edwardatki/e74-cpu/(list of files, drawings)

Other design files:
cpu.circ
