edwardatki/e74-cpu/hardware/Control_board/Control_board.kicad_pcb

## KiCad design hardware/Control_board/Control_board.kicad_pcb (2023-09-10)

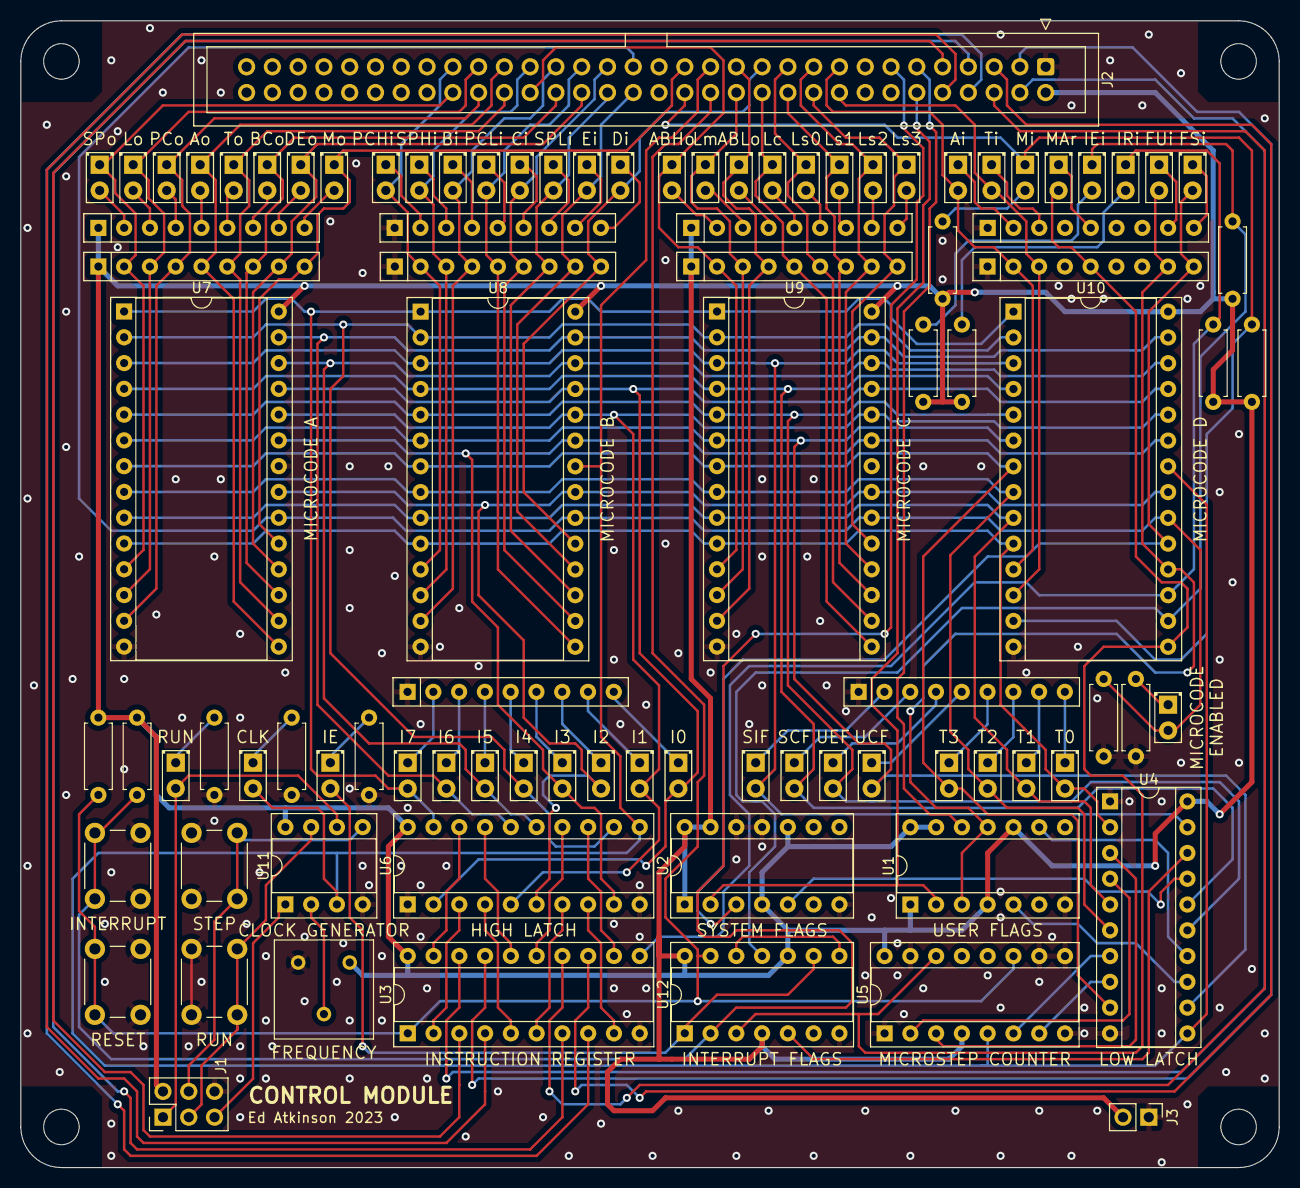
[picture p1: board Control_board.kicad_pcb from above]

Board: 2 copper layers, 124.0 x 113.0 mm, 99 parts (0 on the bottom side), 139 nets.

Parts:
D1, D2, D3, D4, D5, D6, D7, D8, D9, D10, D11, D12, D13, D14, D15, D16, D17, D18, D19, D20, D21, D22, D23, D24, D25, D26, D27, D28, D29, D30, D31, D32, D33, D34, D35, D36, D37, D38, D39, D40, D41, D42, D43, D44, D45, D46, D47, D48, D49, D50, D51, D52: LED; LED_D2.0mm_W4.8mm_H2.5mm_FlatTop
H1, H2, H3, H4: MountingHole; MountingHole_3.5mm
J1: ICSP; PinHeader_2x03_P2.54mm_Vertical
J2: Conn_02x32_Odd_Even; IDC-Header_2x32_P2.54mm_Vertical
J3: Conn_01x02; PinHeader_1x02_P2.54mm_Vertical
R1, R5, R6, R10, R11, R13: 1K; R_Axial_DIN0207_L6.3mm_D2.5mm_P7.62mm_Horizontal
R2, R3, R4, R7, R8, R9, R12: 330R; R_Axial_DIN0207_L6.3mm_D2.5mm_P7.62mm_Horizontal
RN1, RN2, RN3, RN4: 1K; R_Array_SIP9
RN5, RN6, RN7, RN8, RN9, RN10: 330R; R_Array_SIP9
RV1: R_Potentiometer; Potentiometer_Bourns_3386F_Vertical
SW1, SW2, SW3, SW4: SW_Push; SW_PUSH_6mm
U1, U2, U12: 74LS74; DIP-14_W7.62mm_Socket
U3: 74LS273; DIP-20_W7.62mm_Socket
U4, U6: 74LS373; DIP-20_W7.62mm_Socket
U5: 74LS192; DIP-16_W7.62mm_Socket
U7, U8, U9, U10: 27C512; DIP-28_W15.24mm_Socket
U11: ATtiny85-20P; DIP-8_W7.62mm_Socket

Connections:
+5V: J1.2, J2.2, J3.2, R1.1, R5.1, R6.1, R7.2, R8.2, R9.2, R10.1, R13.1, RN3.1 (common), RN4.1 (common), RN8.1 (common), RN10.1 (common), RV1.3, U1.1 (~R), U1.4 (~S), U1.10 (~S), U1.13 (~R), U1.14 (VCC), U2.1 (~R), U2.4 (~S), U2.10 (~S), U2.13 (~R), U2.14 (VCC), U3.20 (VCC), U4.20 (VCC), U5.4 (DOWN), U5.16 (VCC), U6.20 (VCC), U7.28 (VCC), U8.28 (VCC), U9.28 (VCC), U10.28 (VCC), U11.8 (VCC), U12.4 (~S), U12.10 (~S), U12.14 (VCC)
/ALU_M: D45.1 (K), J2.26, RN4.3 (R2), U9.12 (D1)
/ALU_S0: D48.1 (K), J2.21, RN4.6 (R5), U9.16 (D4)
/ALU_S1: D49.1 (K), J2.22, RN4.7 (R6), U9.17 (D5)
/ALU_S2: D50.1 (K), J2.19, RN4.8 (R7), U9.18 (D6)
/ALU_S3: D51.1 (K), J2.20, RN4.9 (R8), U9.19 (D7)
/A_LOAD: D23.2 (A), J2.17, RN1.2 (R1), U10.11 (D0)
/B_LOAD: D38.2 (A), J2.39, RN2.4 (R3), U8.13 (D2)
/CARRY_FLAG: J2.12, U1.2 (D), U2.2 (D)
/CLK: D2.2 (A), J2.27, U4.11 (LE), U5.5 (UP), U6.11 (LE), U8.22 (~OE), U10.22 (~OE), U11.3 (XTAL2/PB4)
/CONTROL_DISABLE: D52.2 (A), J2.33, R11.1, U7.20 (~CE), U8.20 (~CE), U9.20 (~CE), U10.20 (~CE)
/COUNTER_RESET: D25.2 (A), RN1.5 (R4), U5.14 (CLR), U10.15 (D3), U12.3 (C)
/C_LOAD: D40.2 (A), J2.35, RN2.6 (R5), U8.16 (D4)
/D0: J2.9, U3.3 (D0)
/D1: J2.10, U3.4 (D1)
/D2: J2.7, U3.7 (D2)
/D3: J2.8, U3.8 (D3)
/D4: J2.5, U3.13 (D4)
/D5: J2.6, U3.14 (D5)
/D6: J2.3, U3.17 (D6)
/D7: J2.4, U3.18 (D7)
/D_LOAD: D43.2 (A), J2.23, RN2.9 (R8), U8.19 (D7)
/EQUAL_FLAG: J2.11, U1.12 (D)
/E_LOAD: D42.2 (A), J2.34, RN2.8 (R7), U8.18 (D6)
/FLAGS_A_UPDATE: D26.2 (A), RN1.8 (R7), U1.3 (C), U1.11 (C), U10.18 (D6)
/FLAGS_B_UPDATE: D27.2 (A), RN1.9 (R8), U2.3 (C), U10.19 (D7)
/INT_EN_TOGGLE: D21.1 (K), R5.2, U10.16 (D4), U12.11 (C)
/IR_LOAD: D20.1 (K), R1.2, U3.11 (Cp), U10.17 (D5)
/MA0: D3.2 (A), U4.2 (O0), U7.10 (A0), U8.10 (A0), U9.10 (A0), U10.10 (A0)
/MA1: D4.2 (A), U4.5 (O1), U7.9 (A1), U8.9 (A1), U9.9 (A1), U10.9 (A1)
/MA2: D5.2 (A), U4.6 (O2), U7.8 (A2), U8.8 (A2), U9.8 (A2), U10.8 (A2)
/MA3: D7.2 (A), U4.9 (O3), U7.7 (A3), U8.7 (A3), U9.7 (A3), U10.7 (A3)
/MA4: D8.2 (A), U4.12 (O4), U7.6 (A4), U8.6 (A4), U9.6 (A4), U10.6 (A4)
/MA5: D9.2 (A), U4.15 (O5), U7.5 (A5), U8.5 (A5), U9.5 (A5), U10.5 (A5)
/MA6: D10.2 (A), U4.16 (O6), U7.4 (A6), U8.4 (A6), U9.4 (A6), U10.4 (A6)
/MA7: D11.2 (A), U4.19 (O7), U7.3 (A7), U8.3 (A7), U9.3 (A7), U10.3 (A7)
/MA8: D12.2 (A), U6.2 (O0), U7.25 (A8), U8.25 (A8), U9.25 (A8), U10.25 (A8)
/MA9: D13.2 (A), U6.5 (O1), U7.24 (A9), U8.24 (A9), U9.24 (A9), U10.24 (A9)
/MA10: D14.2 (A), U6.6 (O2), U7.21 (A10), U8.21 (A10), U9.21 (A10), U10.21 (A10)
/MA11: D15.2 (A), U6.9 (O3), U7.23 (A11), U8.23 (A11), U9.23 (A11), U10.23 (A11)
/MA12: D16.2 (A), U6.12 (O4), U7.2 (A12), U8.2 (A12), U9.2 (A12), U10.2 (A12)
/MA13: D17.2 (A), U6.15 (O5), U7.26 (A13), U8.26 (A13), U9.26 (A13), U10.26 (A13)
/MA14: D18.2 (A), U6.16 (O6), U7.27 (A14), U8.27 (A14), U9.27 (A14), U10.27 (A14)
/MA15: D19.2 (A), U6.19 (O7), U7.1 (A15), U8.1 (A15), U9.1 (A15), U10.1 (A15)
/PC_H_LOAD: D36.2 (A), J2.47, RN2.2 (R1), U8.11 (D0)
/PC_L_LOAD: D39.2 (A), J2.37, RN2.5 (R4), U8.15 (D3)
/SP_H_LOAD: D37.2 (A), J2.41, RN2.3 (R2), U8.12 (D1)
/SP_L_LOAD: D41.2 (A), J2.36, RN2.7 (R6), U8.17 (D5)
/T_LOAD: D24.2 (A), J2.18, RN1.3 (R2), U10.12 (D1)
/~ADR_H_OUT: D44.1 (K), J2.42, RN4.2 (R1), U9.11 (D0)
/~ADR_L_OUT: D46.1 (K), J2.25, RN4.4 (R3), U9.13 (D2)
/~ALU_CIN: D47.1 (K), J2.24, RN4.5 (R4), U9.15 (D3)
/~ALU_OUT: D29.1 (K), J2.45, RN3.3 (R2), U7.12 (D1)
/~A_OUT: D31.1 (K), J2.43, RN3.5 (R4), U7.15 (D3)
/~BC_OUT: D33.1 (K), J2.40, RN3.7 (R6), U7.17 (D5)
/~DE_OUT: D34.1 (K), J2.38, RN3.8 (R7), U7.18 (D6)
/~INTERRUPT_FLAG: J2.13, R13.2, SW4.1, U12.2 (D)
/~PC_OUT: D30.1 (K), J2.46, RN3.4 (R3), U7.13 (D2)
/~RAM_LOAD: D22.1 (K), J2.30, R6.2, U10.13 (D2)
/~RAM_OUT: D35.1 (K), J2.29, RN3.9 (R8), U7.19 (D7)
/~RESET: J2.28, R10.2, SW3.1, U3.1 (~Mr), U5.11 (~LOAD), U12.13 (~R)
/~SP_OUT: D28.1 (K), J2.48, RN3.2 (R1), U7.11 (D0)
/~T_OUT: D32.1 (K), J2.44, RN3.6 (R5), U7.16 (D4)
GND: J1.6, J2.1, J3.1, R2.2, R3.2, R4.2, R11.2, R12.2, RN1.1 (common), RN2.1 (common), RN5.1 (common), RN6.1 (common), RN7.1 (common), RN9.1 (common), RV1.1, SW1.2, SW2.2, SW3.2, SW4.2, U1.7 (GND), U2.7 (GND), U2.11 (C), U2.12 (D), U3.10 (GND), U4.1 (OE), U4.10 (GND), U5.1 (B), U5.8 (GND), U5.9 (D), U5.10 (C), U5.15 (A), U6.1 (OE), U6.10 (GND), U7.14 (GND), U7.22 (~OE), U8.14 (GND), U9.14 (GND), U9.22 (~OE), U10.14 (GND), U11.4 (GND), U12.7 (GND)
unnamed: D1.2 (A), J1.1, U11.6 (PB1)
unnamed: D1.1 (K), R2.1
unnamed: D2.1 (K), R3.1
unnamed: D3.1 (K), RN5.9 (R8)
unnamed: D4.1 (K), RN5.8 (R7)
unnamed: D5.1 (K), RN5.7 (R6)
unnamed: D6.2 (A), U12.1 (~R), U12.9 (Q)
unnamed: D6.1 (K), R4.1
unnamed: D7.1 (K), RN5.6 (R5)
unnamed: D8.1 (K), RN5.5 (R4)
unnamed: D9.1 (K), RN5.4 (R3)
unnamed: D10.1 (K), RN5.3 (R2)
unnamed: D11.1 (K), RN5.2 (R1)
unnamed: D12.1 (K), RN6.9 (R8)
unnamed: D13.1 (K), RN6.8 (R7)
unnamed: D14.1 (K), RN6.7 (R6)
unnamed: D15.1 (K), RN6.6 (R5)
unnamed: D16.1 (K), RN6.5 (R4)
unnamed: D17.1 (K), RN6.4 (R3)
unnamed: D18.1 (K), RN6.3 (R2)
unnamed: D19.1 (K), RN6.2 (R1)
unnamed: D20.2 (A), R7.1
unnamed: D21.2 (A), R8.1
unnamed: D22.2 (A), R9.1
unnamed: D23.1 (K), RN7.2 (R1)
unnamed: D24.1 (K), RN7.3 (R2)
unnamed: D25.1 (K), RN7.5 (R4)
unnamed: D26.1 (K), RN7.8 (R7)
unnamed: D27.1 (K), RN7.9 (R8)
unnamed: D28.2 (A), RN8.2 (R1)
unnamed: D29.2 (A), RN8.3 (R2)
unnamed: D30.2 (A), RN8.4 (R3)
unnamed: D31.2 (A), RN8.5 (R4)
unnamed: D32.2 (A), RN8.6 (R5)
unnamed: D33.2 (A), RN8.7 (R6)
unnamed: D34.2 (A), RN8.8 (R7)
unnamed: D35.2 (A), RN8.9 (R8)
unnamed: D36.1 (K), RN9.2 (R1)
unnamed: D37.1 (K), RN9.3 (R2)
unnamed: D38.1 (K), RN9.4 (R3)
unnamed: D39.1 (K), RN9.5 (R4)
unnamed: D40.1 (K), RN9.6 (R5)
unnamed: D41.1 (K), RN9.7 (R6)
unnamed: D42.1 (K), RN9.8 (R7)
unnamed: D43.1 (K), RN9.9 (R8)
unnamed: D44.2 (A), RN10.2 (R1)
unnamed: D45.2 (A), RN10.3 (R2)
unnamed: D46.2 (A), RN10.4 (R3)
unnamed: D47.2 (A), RN10.5 (R4)
unnamed: D48.2 (A), RN10.6 (R5)
unnamed: D49.2 (A), RN10.7 (R6)
unnamed: D50.2 (A), RN10.8 (R7)
unnamed: D51.2 (A), RN10.9 (R8)
unnamed: D52.1 (K), R12.1
unnamed: J1.3, SW1.1, U11.7 (PB2)
unnamed: J1.4, SW2.1, U11.5 (AREF/PB0)
unnamed: J1.5, U11.1 (~RESET/PB5)
unnamed: U1.5 (Q), U4.13 (D4)
unnamed: U1.9 (Q), U4.14 (D5)
unnamed: U2.5 (Q), U4.17 (D6)
unnamed: U3.2 (Q0), U6.3 (D0)
unnamed: U3.5 (Q1), U6.4 (D1)
unnamed: U3.6 (Q2), U6.7 (D2)
unnamed: U3.9 (Q3), U6.8 (D3)
unnamed: U3.12 (Q4), U6.13 (D4)
unnamed: U3.15 (Q5), U6.14 (D5)
unnamed: U3.16 (Q6), U6.17 (D6)
unnamed: U3.19 (Q7), U6.18 (D7)
unnamed: U4.3 (D0), U5.3 (QA)
unnamed: U4.4 (D1), U5.2 (QB)
unnamed: U4.7 (D2), U5.6 (QC)
unnamed: U4.8 (D3), U5.7 (QD)
unnamed: RV1.2, U11.2 (XTAL1/PB3)
unnamed: U4.18 (D7), U12.5 (Q)
unnamed: U12.8 (~Q), U12.12 (D)
