edwardatki/e74-cpu/hardware/Memory_board/Memory_board.kicad_pcb

## KiCad design hardware/Memory_board/Memory_board.kicad_pcb (2023-09-10)

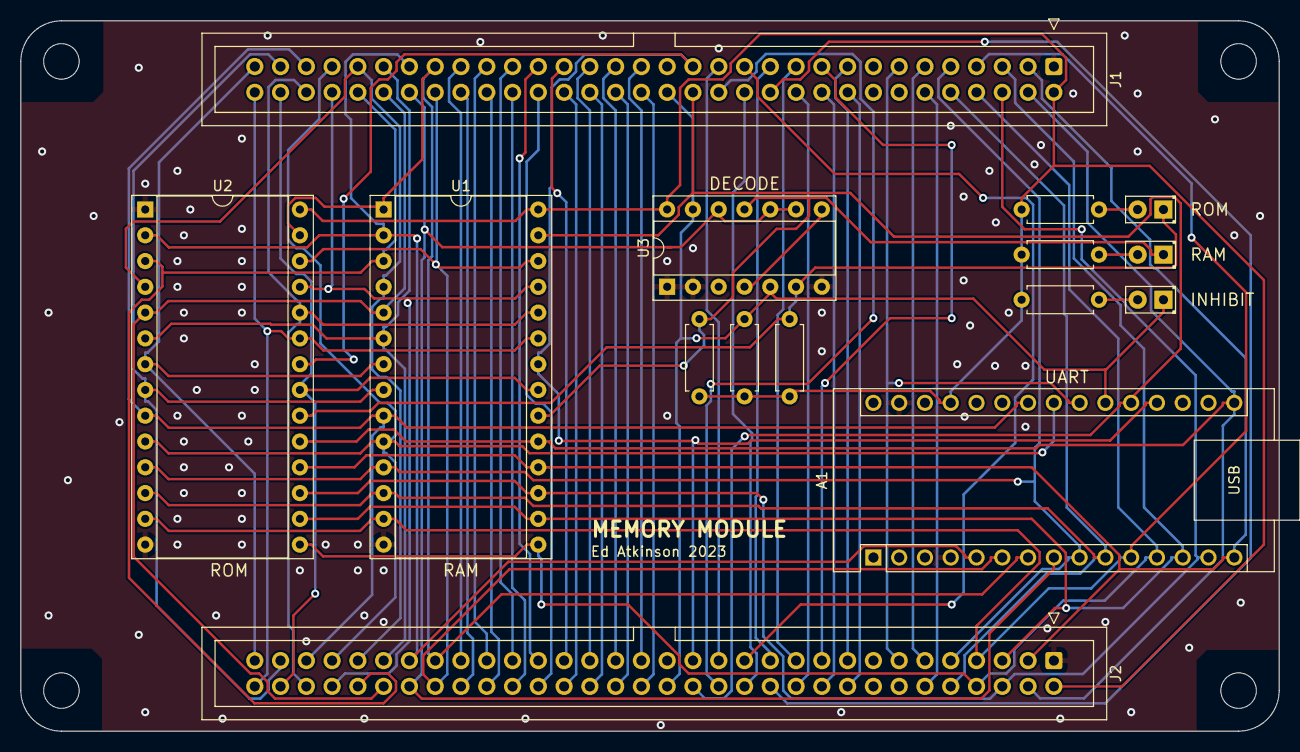
[picture p2: board Memory_board.kicad_pcb from above]

Board: 2 copper layers, 124.0 x 70.0 mm, 19 parts (0 on the bottom side), 66 nets.

Parts:
A1: Arduino_Nano_v3.x; Arduino_Nano
D1, D2, D3: LED; LED_D2.0mm_W4.8mm_H2.5mm_FlatTop
H1, H2, H3, H4: MountingHole; MountingHole_3.5mm
J1, J2: Conn_02x32_Odd_Even; IDC-Header_2x32_P2.54mm_Vertical
R1, R5, R6: 1K; R_Axial_DIN0207_L6.3mm_D2.5mm_P7.62mm_Horizontal
R2, R3, R4: 330R; R_Axial_DIN0207_L6.3mm_D2.5mm_P7.62mm_Horizontal
U1: CY62256-70PC; DIP-28_W15.24mm_Socket
U2: 27C512; DIP-28_W15.24mm_Socket
U3: 74LS00; DIP-14_W7.62mm_Socket

Connections:
+5V: A1.27 (+5V), J1.2, J2.2, R1.2, R2.2, R3.2, R4.2, R5.1, R6.1, U1.28 (VCC), U2.28 (VCC), U3.14 (VCC)
/A0: A1.23 (A4), J1.57, J2.57, U1.10 (A0), U2.10 (A0)
/A1: A1.24 (A5), J1.59, J2.59, U1.9 (A1), U2.9 (A1)
/A2: J1.61, J2.61, U1.8 (A2), U2.8 (A2)
/A3: J1.63, J2.63, U1.7 (A3), U2.7 (A3)
/A4: J1.53, J2.53, U1.6 (A4), U2.6 (A4)
/A5: J1.54, J2.54, U1.5 (A5), U2.5 (A5)
/A6: J1.55, J2.55, U1.4 (A6), U2.4 (A6)
/A7: J1.56, J2.56, U1.3 (A7), U2.3 (A7)
/A8: J1.58, J2.58, U1.25 (A8), U2.25 (A8)
/A9: J1.60, J2.60, U1.24 (A9), U2.24 (A9)
/A10: J1.62, J2.62, U1.21 (A10), U2.21 (A10)
/A11: J1.64, J2.64, U1.23 (A11), U2.23 (A11)
/A12: A1.5 (D2), J1.51, J2.51, U1.2 (A12), U2.2 (A12)
/A13: A1.6 (D3), J1.50, J2.50, U1.26 (A13), U2.26 (A13)
/A14: A1.7 (D4), J1.49, J2.49, U1.1 (A14), U2.27 (A14)
/A15: A1.8 (D5), J1.52, J2.52, U3.9, U3.10, U3.12
/ALU_M: J1.26, J2.26
/ALU_S0: J1.21, J2.21
/ALU_S1: J1.22, J2.22
/ALU_S2: J1.19, J2.19
/ALU_S3: J1.20, J2.20
/A_LOAD: J1.17, J2.17
/B_LOAD: J1.39, J2.39
/CARRY_FLAG: J1.12, J2.12
/CLK: J1.27, J2.27
/CONTROL_DISABLE: J1.33, J2.33
/C_LOAD: J1.35, J2.35
/D0: A1.9 (D6), J1.9, J2.9, U1.11 (Q0), U2.11 (D0)
/D1: A1.10 (D7), J1.10, J2.10, U1.12 (Q1), U2.12 (D1)
/D2: A1.11 (D8), J1.7, J2.7, U1.13 (Q2), U2.13 (D2)
/D3: A1.12 (D9), J1.8, J2.8, U1.15 (Q3), U2.15 (D3)
/D4: A1.13 (D10), J1.5, J2.5, U1.16 (Q4), U2.16 (D4)
/D5: A1.14 (D11), J1.6, J2.6, U1.17 (Q5), U2.17 (D5)
/D6: A1.15 (D12), J1.3, J2.3, U1.18 (Q6), U2.18 (D6)
/D7: A1.16 (D13), J1.4, J2.4, U1.19 (Q7), U2.19 (D7)
/D_LOAD: J1.23, J2.23
/EQUAL_FLAG: J1.11, J2.11
/E_LOAD: J1.34, J2.34
/PC_H_LOAD: J1.47, J2.47
/PC_L_LOAD: J1.37, J2.37
/SP_H_LOAD: J1.41, J2.41
/SP_L_LOAD: J1.36, J2.36
/T_LOAD: J1.18, J2.18
/~ADR_H_OUT: J1.42, J2.42
/~ADR_L_OUT: J1.25, J2.25
/~ALU_CIN: J1.24, J2.24
/~ALU_OUT: J1.45, J2.45
/~A_OUT: J1.43, J2.43
/~BC_OUT: J1.40, J2.40
/~DE_OUT: J1.38, J2.38
/~INTERRUPT_FLAG: A1.22 (A3), J1.13, J2.13
/~MEM_INHIBIT: A1.21 (A2), D3.1 (K), J1.32, J2.32, R1.1, U3.5, U3.13
/~MEM_LOAD: A1.20 (A1), J1.30, J2.30, U1.27 (~WE)
/~MEM_OUT: A1.19 (A0), J1.29, J2.29, U1.22 (~OE), U2.22 (~OE)
/~PC_OUT: J1.46, J2.46
/~RAM_CE: D1.1 (K), R5.2, U1.20 (~CS), U3.11
/~RESET: J1.28, J2.28
/~ROM_CE: D2.1 (K), R6.2, U2.20 (~CE), U3.6
/~SP_OUT: J1.48, J2.48
/~T_OUT: J1.44, J2.44
GND: A1.4 (GND), A1.29 (GND), J1.1, J2.1, U1.14 (GND), U2.1 (A15), U2.14 (GND), U3.1, U3.2, U3.7 (GND)
unnamed: D1.2 (A), R2.1
unnamed: D2.2 (A), R3.1
unnamed: D3.2 (A), R4.1
unnamed: U3.4, U3.8
