edwardatki/e74-cpu/hardware/Register_board/Register_board.kicad_pcb

## KiCad design hardware/Register_board/Register_board.kicad_pcb (2023-09-02)

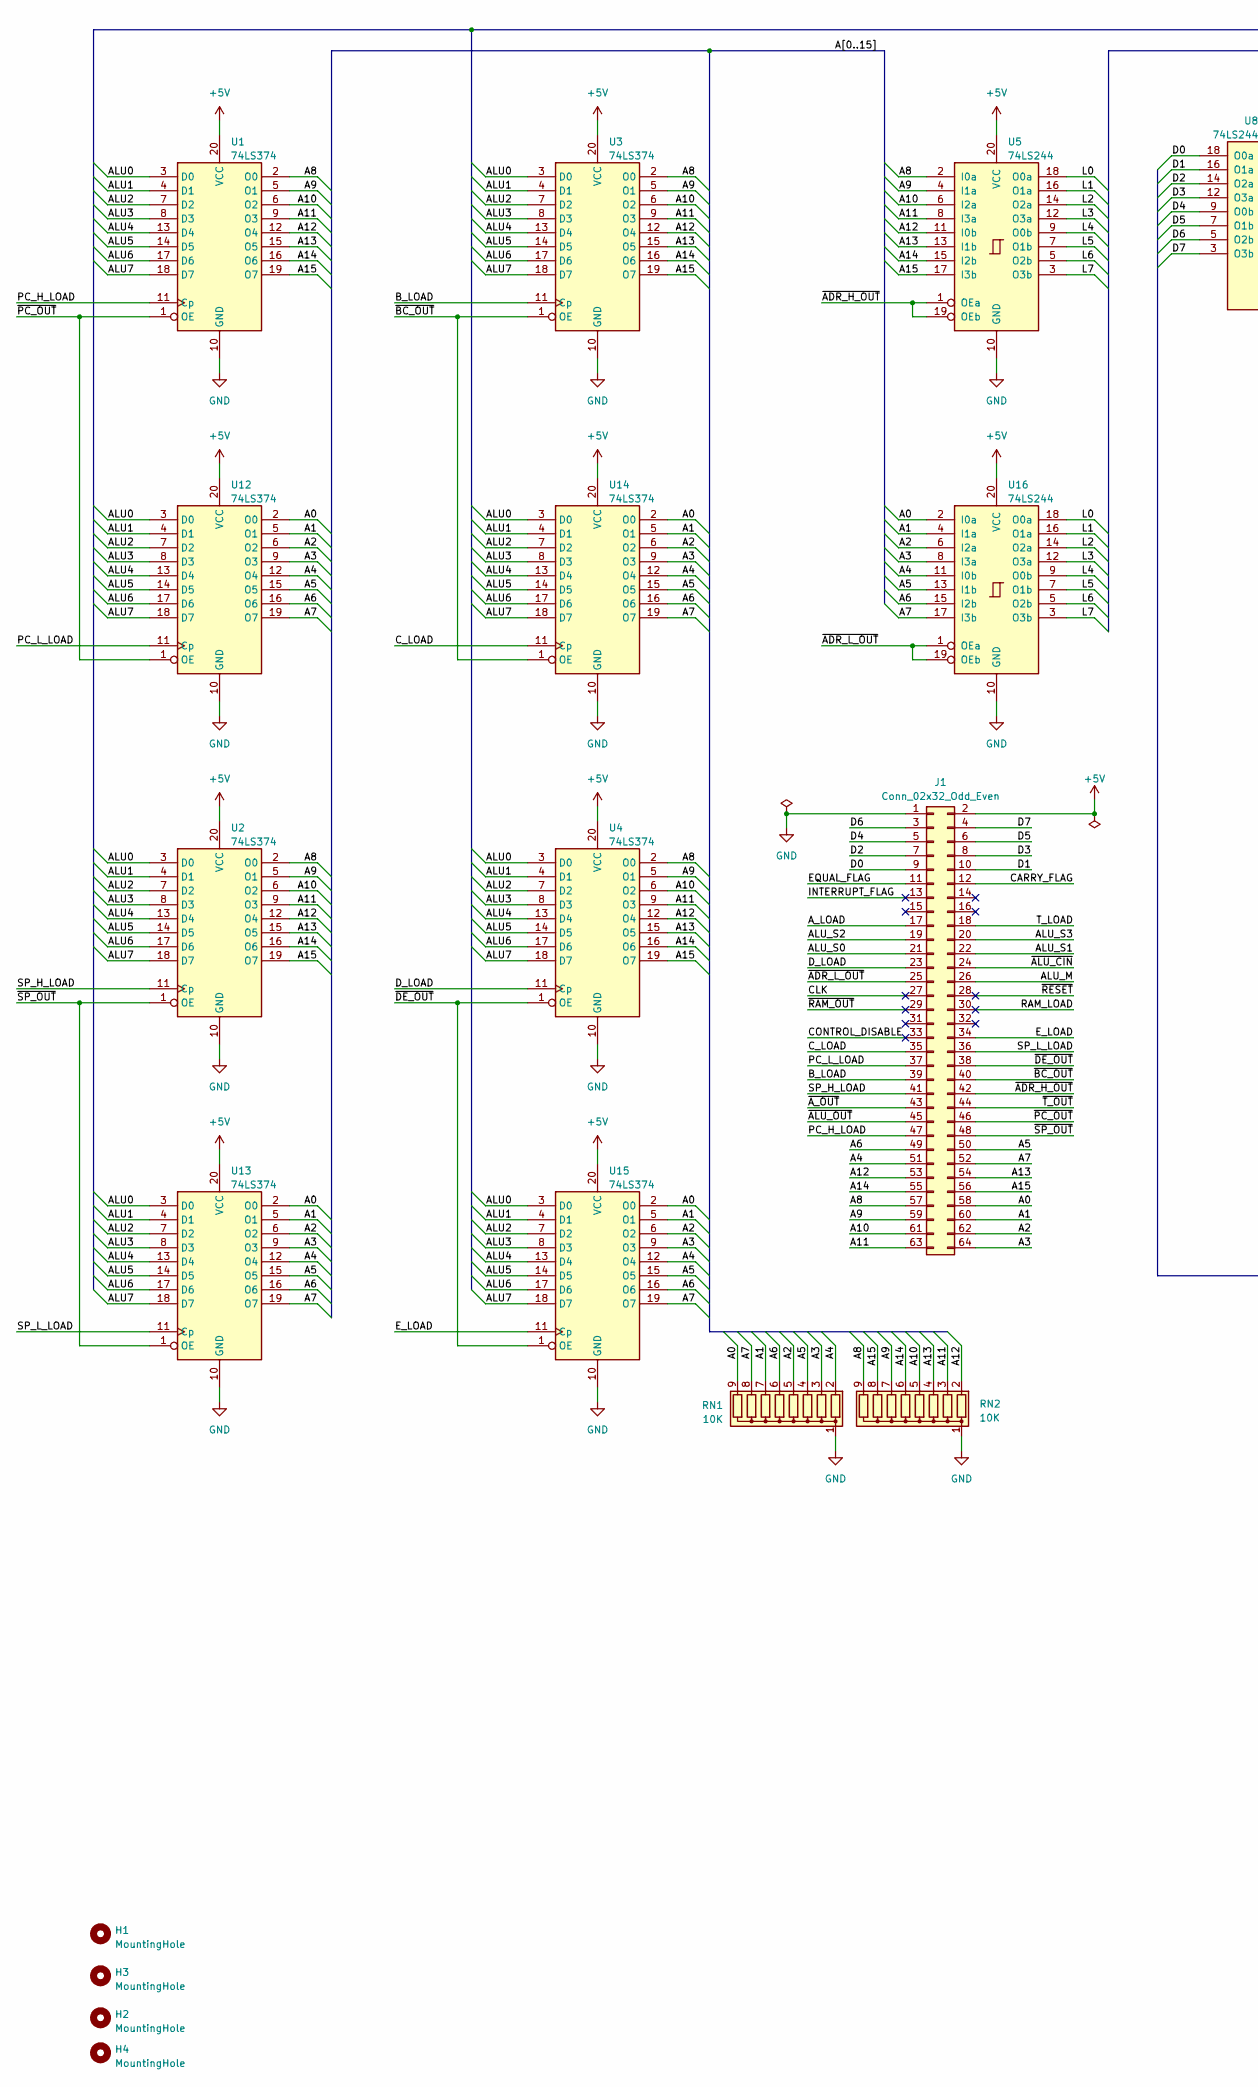
[picture p3: schematic Register_board.kicad_sch, part in row 1, column 1]

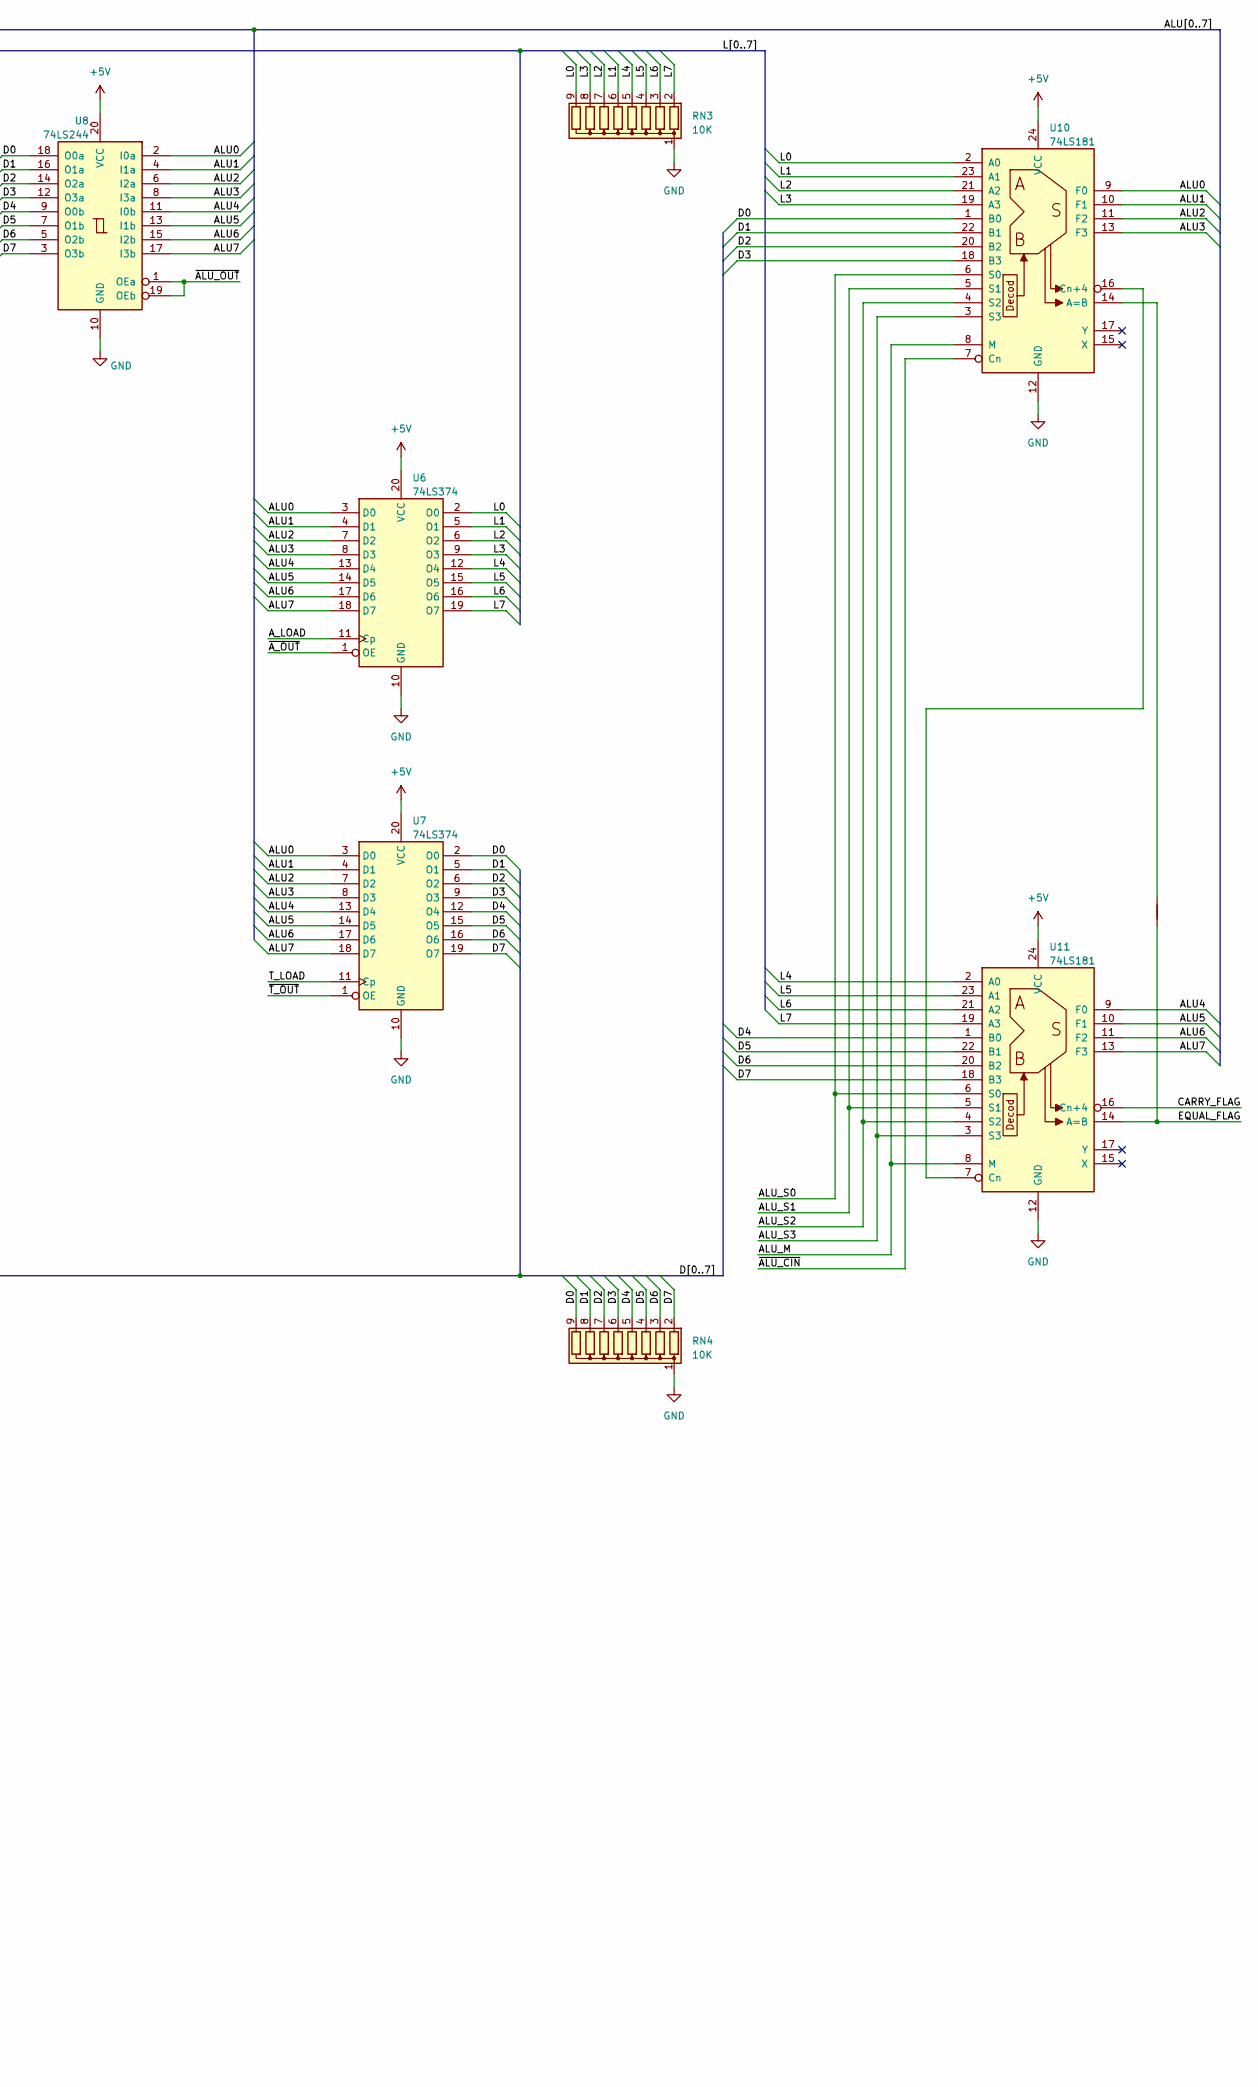
[picture p4: schematic Register_board.kicad_sch, part in row 1, column 2]

Parts:
H1, H2, H3, H4: MountingHole; MountingHole_3.5mm
J1: Conn_02x32_Odd_Even; IDC-Header_2x32_P2.54mm_Vertical
NT1: NetTie_2; NetTie-2_SMD_Pad0.5mm
RN1, RN2, RN3, RN4: 10K; R_Array_SIP9
U1, U2, U3, U4, U6, U7, U12, U13, U14, U15: 74LS374; DIP-20_W7.62mm_Socket
U5, U8, U16: 74LS244; DIP-20_W7.62mm_Socket
U10, U11: 74LS181; DIP-24_W15.24mm_Socket

Connections:
+5V: J1.2, U1.20 (VCC), U2.20 (VCC), U3.20 (VCC), U4.20 (VCC), U5.20 (VCC), U6.20 (VCC), U7.20 (VCC), U8.20 (VCC), U10.24 (VCC), U11.24 (VCC), U12.20 (VCC), U13.20 (VCC), U14.20 (VCC), U15.20 (VCC), U16.20 (VCC); also elsewhere on the board
/A0: J1.58, RN1.9 (R8), U12.2 (O0), U13.2 (O0), U14.2 (O0), U15.2 (O0), U16.2 (I0a)
/A1: J1.60, RN1.7 (R6), U12.5 (O1), U13.5 (O1), U14.5 (O1), U15.5 (O1), U16.4 (I1a)
/A2: J1.62, RN1.5 (R4), U12.6 (O2), U13.6 (O2), U14.6 (O2), U15.6 (O2), U16.6 (I2a)
/A3: J1.64, RN1.3 (R2), U12.9 (O3), U13.9 (O3), U14.9 (O3), U15.9 (O3), U16.8 (I3a)
/A4: J1.51, RN1.2 (R1), U12.12 (O4), U13.12 (O4), U14.12 (O4), U15.12 (O4), U16.11 (I0b)
/A5: J1.50, RN1.4 (R3), U12.15 (O5), U13.15 (O5), U14.15 (O5), U15.15 (O5), U16.13 (I1b)
/A6: J1.49, RN1.6 (R5), U12.16 (O6), U13.16 (O6), U14.16 (O6), U15.16 (O6), U16.15 (I2b)
/A7: J1.52, RN1.8 (R7), U12.19 (O7), U13.19 (O7), U14.19 (O7), U15.19 (O7), U16.17 (I3b)
/A8: J1.57, RN2.9 (R8), U1.2 (O0), U2.2 (O0), U3.2 (O0), U4.2 (O0), U5.2 (I0a)
/A9: J1.59, RN2.7 (R6), U1.5 (O1), U2.5 (O1), U3.5 (O1), U4.5 (O1), U5.4 (I1a)
/A10: J1.61, RN2.5 (R4), U1.6 (O2), U2.6 (O2), U3.6 (O2), U4.6 (O2), U5.6 (I2a)
/A11: J1.63, RN2.3 (R2), U1.9 (O3), U2.9 (O3), U3.9 (O3), U4.9 (O3), U5.8 (I3a)
/A12: J1.53, RN2.2 (R1), U1.12 (O4), U2.12 (O4), U3.12 (O4), U4.12 (O4), U5.11 (I0b)
/A13: J1.54, RN2.4 (R3), U1.15 (O5), U2.15 (O5), U3.15 (O5), U4.15 (O5), U5.13 (I1b)
/A14: J1.55, RN2.6 (R5), U1.16 (O6), U2.16 (O6), U3.16 (O6), U4.16 (O6), U5.15 (I2b)
/A15: J1.56, RN2.8 (R7), U1.19 (O7), U2.19 (O7), U3.19 (O7), U4.19 (O7), U5.17 (I3b)
/ALU0: U1.3 (D0), U2.3 (D0), U3.3 (D0), U4.3 (D0), U6.3 (D0), U7.3 (D0), U8.2 (I0a), U10.9 (F0), U12.3 (D0), U13.3 (D0), U14.3 (D0), U15.3 (D0)
/ALU1: U1.4 (D1), U2.4 (D1), U3.4 (D1), U4.4 (D1), U6.4 (D1), U7.4 (D1), U8.4 (I1a), U10.10 (F1), U12.4 (D1), U13.4 (D1), U14.4 (D1), U15.4 (D1)
/ALU2: U1.7 (D2), U2.7 (D2), U3.7 (D2), U4.7 (D2), U6.7 (D2), U7.7 (D2), U8.6 (I2a), U10.11 (F2), U12.7 (D2), U13.7 (D2), U14.7 (D2), U15.7 (D2)
/ALU3: U1.8 (D3), U2.8 (D3), U3.8 (D3), U4.8 (D3), U6.8 (D3), U7.8 (D3), U8.8 (I3a), U10.13 (F3), U12.8 (D3), U13.8 (D3), U14.8 (D3), U15.8 (D3)
/ALU4: U1.13 (D4), U2.13 (D4), U3.13 (D4), U4.13 (D4), U6.13 (D4), U7.13 (D4), U8.11 (I0b), U11.9 (F0), U12.13 (D4), U13.13 (D4), U14.13 (D4), U15.13 (D4)
/ALU5: U1.14 (D5), U2.14 (D5), U3.14 (D5), U4.14 (D5), U6.14 (D5), U7.14 (D5), U8.13 (I1b), U11.10 (F1), U12.14 (D5), U13.14 (D5), U14.14 (D5), U15.14 (D5)
/ALU6: U1.17 (D6), U2.17 (D6), U3.17 (D6), U4.17 (D6), U6.17 (D6), U7.17 (D6), U8.15 (I2b), U11.11 (F2), U12.17 (D6), U13.17 (D6), U14.17 (D6), U15.17 (D6)
/ALU7: U1.18 (D7), U2.18 (D7), U3.18 (D7), U4.18 (D7), U6.18 (D7), U7.18 (D7), U8.17 (I3b), U11.13 (F3), U12.18 (D7), U13.18 (D7), U14.18 (D7), U15.18 (D7)
/ALU_M: J1.26, U10.8 (M), U11.8 (M)
/ALU_S0: J1.21, U10.6 (S0), U11.6 (S0)
/ALU_S1: J1.22, U10.5 (S1), U11.5 (S1)
/ALU_S2: J1.19, U10.4 (S2), U11.4 (S2)
/ALU_S3: J1.20, U10.3 (S3), U11.3 (S3)
/A_LOAD: J1.17, U6.11 (Cp)
/B_LOAD: J1.39, U3.11 (Cp)
/CARRY_FLAG_B: J1.16; also elsewhere on the board
/CLK: J1.27
/CONTROL_DISABLE: J1.33
/C_LOAD: J1.35, U14.11 (Cp)
/D0: J1.9, RN4.9 (R8), U7.2 (O0), U8.18 (O0a), U10.1 (B0)
/D1: J1.10, RN4.8 (R7), U7.5 (O1), U8.16 (O1a), U10.22 (B1)
/D2: J1.7, RN4.7 (R6), U7.6 (O2), U8.14 (O2a), U10.20 (B2)
/D3: J1.8, RN4.6 (R5), U7.9 (O3), U8.12 (O3a), U10.18 (B3)
/D4: J1.5, RN4.5 (R4), U7.12 (O4), U8.9 (O0b), U11.1 (B0)
/D5: J1.6, RN4.4 (R3), U7.15 (O5), U8.7 (O1b), U11.22 (B1)
/D6: J1.3, RN4.3 (R2), U7.16 (O6), U8.5 (O2b), U11.20 (B2)
/D7: J1.4, RN4.2 (R1), U7.19 (O7), U8.3 (O3b), U11.18 (B3)
/D_LOAD: J1.23, U4.11 (Cp)
/EQUAL_FLAG_B: J1.15; also elsewhere on the board
/E_LOAD: J1.34, U15.11 (Cp)
/FLAGS_A_UPDATE: J1.14; also elsewhere on the board
/FLAGS_B_UPDATE: J1.13; also elsewhere on the board
/L0: RN3.9 (R8), U5.18 (O0a), U6.2 (O0), U10.2 (A0), U16.18 (O0a)
/L1: RN3.6 (R5), U5.16 (O1a), U6.5 (O1), U10.23 (A1), U16.16 (O1a)
/L2: RN3.7 (R6), U5.14 (O2a), U6.6 (O2), U10.21 (A2), U16.14 (O2a)
/L3: RN3.8 (R7), U5.12 (O3a), U6.9 (O3), U10.19 (A3), U16.12 (O3a)
/L4: RN3.5 (R4), U5.9 (O0b), U6.12 (O4), U11.2 (A0), U16.9 (O0b)
/L5: RN3.4 (R3), U5.7 (O1b), U6.15 (O5), U11.23 (A1), U16.7 (O1b)
/L6: RN3.3 (R2), U5.5 (O2b), U6.16 (O6), U11.21 (A2), U16.5 (O2b)
/L7: RN3.2 (R1), U5.3 (O3b), U6.19 (O7), U11.19 (A3), U16.3 (O3b)
/PC_H_LOAD: J1.47, U1.11 (Cp)
/PC_L_LOAD: J1.37, U12.11 (Cp)
/RAM_LOAD: J1.30
/SP_H_LOAD: J1.41, U2.11 (Cp)
/SP_L_LOAD: J1.36, U13.11 (Cp)
/T_LOAD: J1.18, U7.11 (Cp)
/~ADR_H_OUT: J1.42, U5.1 (OEa), U5.19 (OEb)
/~ADR_L_OUT: J1.25, U16.1 (OEa), U16.19 (OEb)
/~ALU_CIN: J1.24, U10.7 (Cn)
/~ALU_OUT: J1.45, U8.1 (OEa), U8.19 (OEb)
/~A_OUT: J1.43, U6.1 (OE)
/~BC_OUT: J1.40, U3.1 (OE), U14.1 (OE)
/~DE_OUT: J1.38, U4.1 (OE), U15.1 (OE)
/~PC_OUT: J1.46, U1.1 (OE), U12.1 (OE)
/~RAM_OUT: J1.29
/~RESET: J1.28
/~SP_OUT: J1.48, U2.1 (OE), U13.1 (OE)
/~T_OUT: J1.44, U7.1 (OE)
GND: J1.1, RN1.1 (common), RN2.1 (common), RN3.1 (common), RN4.1 (common), U1.10 (GND), U2.10 (GND), U3.10 (GND), U4.10 (GND), U5.10 (GND), U6.10 (GND), U7.10 (GND), U8.10 (GND), U10.12 (GND), U11.12 (GND), U12.10 (GND), U13.10 (GND), U14.10 (GND), U15.10 (GND), U16.10 (GND); also elsewhere on the board
unnamed: NT1.1, U10.14 (A=B)
unnamed: U10.16 (Cn+4), U11.7 (Cn)

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
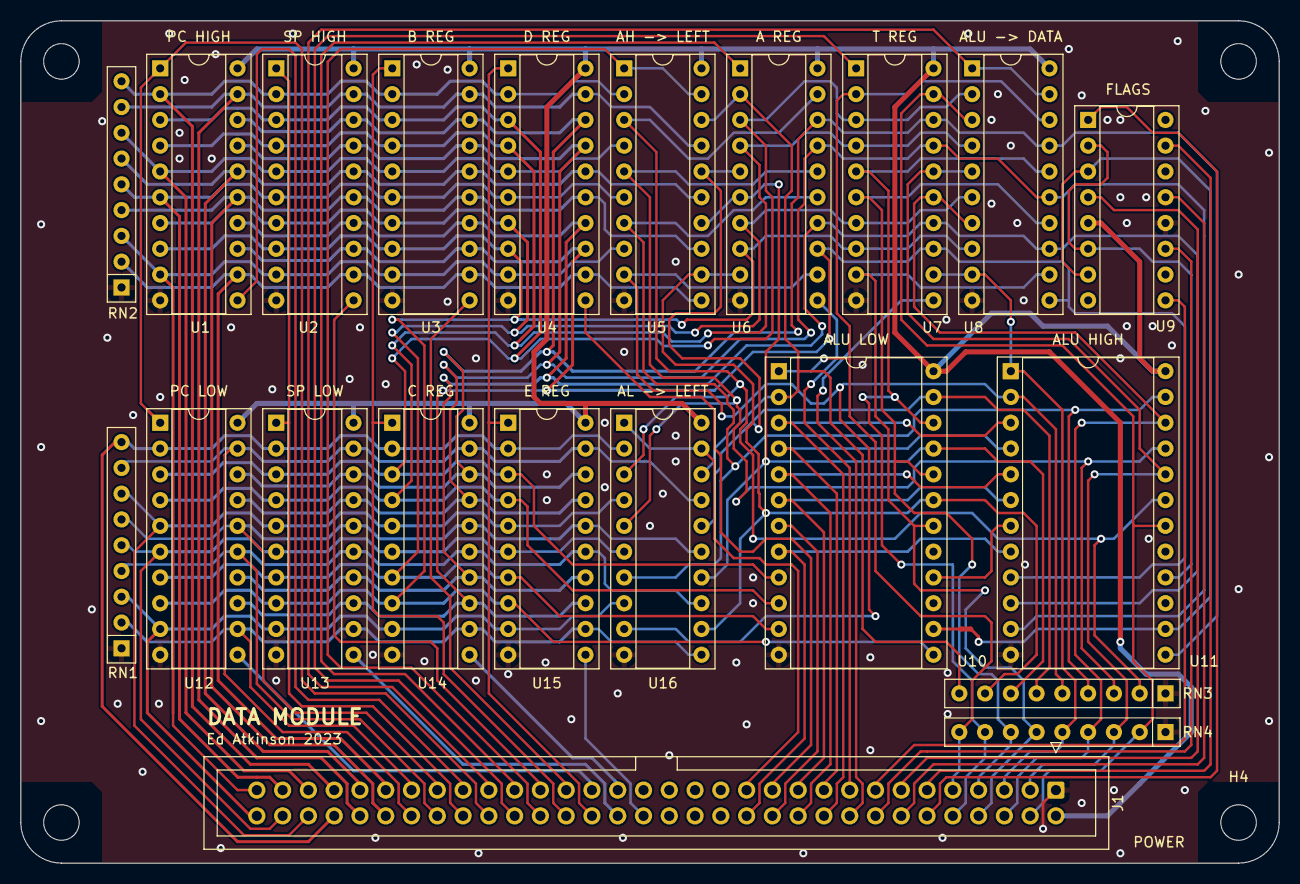
[picture p5: board Register_board.kicad_pcb from above]

Board: 2 copper layers, 124.0 x 83.0 mm, 26 parts (0 on the bottom side), 77 nets.

Other parts of the board:
U9: 74LS75; DIP-16_W7.62mm_Socket

Their connections:
+5V: U9.5 (VCC); also elsewhere on the board
/CARRY_FLAG_B: U9.11 (~Q2); also elsewhere on the board
/EQUAL_FLAG_B: U9.9 (Q3); also elsewhere on the board
/FLAGS_A_UPDATE: U9.13 (E01); also elsewhere on the board
/FLAGS_B_UPDATE: U9.4 (E23); also elsewhere on the board
GND: U9.12 (GND); also elsewhere on the board
