edwardatki/e74-cpu/arduino/clock_generator/clock_generator.ino

bool running = false;
bool clock_state = false;

const int RUN_SW_PIN = 2;
const int STEP_SW_PIN = 0;
const int POTENTIOMETER_PIN = 3;
const int CLOCK_PIN = 4;
const int RUN_LED_PIN = 1;

void setup() {
  pinMode(RUN_SW_PIN, INPUT_PULLUP);
  pinMode(STEP_SW_PIN, INPUT_PULLUP);
  pinMode(POTENTIOMETER_PIN, INPUT);
  pinMode(CLOCK_PIN, OUTPUT);
  digitalWrite(CLOCK_PIN, clock_state);
  pinMode(RUN_LED_PIN, OUTPUT);
  digitalWrite(RUN_LED_PIN, running);
}

void loop() {
  static unsigned long period = 100000;
  static int loop_count = 0;

  // Don't do slow stuff every loop
  if (loop_count++ > 1000) {
    static unsigned long run_press_start = millis();
    static bool run_one_shot = false;
    if (digitalRead(RUN_SW_PIN)) {
      run_press_start = millis();
      run_one_shot = false;
    }
    
    if ((!run_one_shot) && ((millis() - run_press_start) > 20)) {
      running = !running;
      digitalWrite(RUN_LED_PIN, running);
      run_one_shot = true;
    }

    static unsigned long step_press_start = millis();
    static bool step_one_shot = false;
    if (digitalRead(STEP_SW_PIN)) {
      step_press_start = millis();
      step_one_shot = false;
    }
    
    if ((!step_one_shot) && ((millis() - step_press_start) > 20)) {
      clock_state = !clock_state;
      step_one_shot = true;
    }

    // Read is 0 to 1023, clock should be 10Hz to 10KHz so period 50 to 51150
    period = 51150/(analogRead(POTENTIOMETER_PIN)+1);
    loop_count = 0;
  }


  if (running) {
    static unsigned long last_toggle = micros();
    unsigned long next_toggle = last_toggle + period;
    if (micros() > next_toggle) {
      clock_state = !clock_state;
      digitalWrite(CLOCK_PIN, clock_state);
      last_toggle = micros();
    }
  } else {
    digitalWrite(CLOCK_PIN, clock_state);
  }
}
