edwardatki/e74-cpu/programs/disassembly_table.asm

disassembly_table:
#d16 .undefined

#d16 .mov_a_i8
#d16 .mov_b_i8
#d16 .mov_c_i8
#d16 .mov_d_i8
#d16 .mov_e_i8

#d16 .mov_bc_i16
#d16 .mov_de_i16
#d16 .mov_sp_i16

#d16 .add_i8
#d16 .sub_i8
#d16 .and_i8
#d16 .nand_i8
#d16 .or_i8
#d16 .nor_i8
#d16 .xor_i8

#d16 .add_b
#d16 .sub_b
#d16 .and_b
#d16 .nand_b
#d16 .or_b
#d16 .nor_b
#d16 .xor_b

#d16 .add_c
#d16 .sub_c
#d16 .and_c
#d16 .nand_c
#d16 .or_c
#d16 .nor_c
#d16 .xor_c

#d16 .add_d
#d16 .sub_d
#d16 .and_d
#d16 .nand_d
#d16 .or_d
#d16 .nor_d
#d16 .xor_d

#d16 .add_e
#d16 .sub_e
#d16 .and_e
#d16 .nand_e
#d16 .or_e
#d16 .nor_e
#d16 .xor_e

#d16 .add_at_bc
#d16 .sub_at_bc
#d16 .and_at_bc
#d16 .nand_at_bc
#d16 .or_at_bc
#d16 .nor_at_bc
#d16 .xor_at_bc

#d16 .add_at_de
#d16 .sub_at_de
#d16 .and_at_de
#d16 .nand_at_de
#d16 .or_at_de
#d16 .nor_at_de
#d16 .xor_at_de

#d16 .not

#d16 .push_a
#d16 .push_b
#d16 .push_c
#d16 .push_d
#d16 .push_e

#d16 .pop_a
#d16 .pop_b
#d16 .pop_c
#d16 .pop_d
#d16 .pop_e

#d16 .push_bc
#d16 .push_de

#d16 .pop_bc
#d16 .pop_de

#d16 .inc_bc
#d16 .inc_de

#d16 .dec_bc
#d16 .dec_de

#d16 .jmp_i16
#d16 .jmp_bc
#d16 .jmp_de
#d16 .jmp_at_bc
#d16 .jmp_at_de

#d16 .jc_i16
#d16 .jc_bc
#d16 .jc_de
#d16 .jc_at_bc
#d16 .jc_at_de

#d16 .jnc_i16
#d16 .jnc_bc
#d16 .jnc_de
#d16 .jnc_at_bc
#d16 .jnc_at_de

#d16 .je_i16
#d16 .je_bc
#d16 .je_de
#d16 .je_at_bc
#d16 .je_at_de

#d16 .jne_i16
#d16 .jne_bc
#d16 .jne_de
#d16 .jne_at_bc
#d16 .jne_at_de

#d16 .cmp_i8
#d16 .cmp_b
#d16 .cmp_c
#d16 .cmp_d
#d16 .cmp_e
#d16 .cmp_at_bc
#d16 .cmp_at_de

#d16 .mov_a_at_bc
#d16 .mov_d_at_bc
#d16 .mov_e_at_bc

#d16 .mov_a_at_de
#d16 .mov_b_at_de
#d16 .mov_c_at_de

#d16 .mov_at_bc_a
#d16 .mov_at_bc_d
#d16 .mov_at_bc_e

#d16 .mov_at_de_a
#d16 .mov_at_de_b
#d16 .mov_at_de_c

#d16 .mov_bc_at_de
#d16 .mov_de_at_bc

#d16 .mov_at_bc_de
#d16 .mov_at_de_bc

#d16 .call_i16
#d16 .call_bc
#d16 .call_de
#d16 .call_at_bc
#d16 .call_at_de

#d16 .ret

#d16 .mov_b_a
#d16 .mov_b_c
#d16 .mov_b_d
#d16 .mov_b_e

#d16 .mov_c_a
#d16 .mov_c_b
#d16 .mov_c_d
#d16 .mov_c_e

#d16 .mov_d_a
#d16 .mov_d_b
#d16 .mov_d_c
#d16 .mov_d_e

#d16 .mov_e_a
#d16 .mov_e_b
#d16 .mov_e_c
#d16 .mov_e_d

#d16 .mov_bc_de
#d16 .mov_bc_sp

#d16 .mov_de_bc
#d16 .mov_de_sp

#d16 .mov_sp_bc
#d16 .mov_sp_de

#d16 .rol

#d16 .mov_bc_sp_plus_i8
#d16 .mov_de_sp_plus_i8

#d16 .inc_b
#d16 .inc_c
#d16 .inc_d
#d16 .inc_e

#d16 .dec_b
#d16 .dec_c
#d16 .dec_d
#d16 .dec_e

#d16 .mov_a_b
#d16 .mov_a_c
#d16 .mov_a_d
#d16 .mov_a_e

#d16 .mov_bc_sp_minus_i8
#d16 .mov_de_sp_minus_i8

#d16 .mov_sp_sp_plus_i8
#d16 .mov_sp_sp_minus_i8

#d16 .tei
#d16 .reti

#d16 .ldc
#d16 .lde

#d16 .pushf
#d16 .popf

#d16 .undefined ; B2
#d16 .undefined
#d16 .undefined
#d16 .undefined
#d16 .undefined
#d16 .undefined
#d16 .undefined
#d16 .undefined
#d16 .undefined
#d16 .undefined
#d16 .undefined
#d16 .undefined
#d16 .undefined
#d16 .undefined
#d16 .undefined ; C0
#d16 .undefined
#d16 .undefined
#d16 .undefined
#d16 .undefined
#d16 .undefined
#d16 .undefined
#d16 .undefined
#d16 .undefined
#d16 .undefined
#d16 .undefined
#d16 .undefined
#d16 .undefined
#d16 .undefined
#d16 .undefined
#d16 .undefined
#d16 .undefined ; D0
#d16 .undefined
#d16 .undefined
#d16 .undefined
#d16 .undefined
#d16 .undefined
#d16 .undefined
#d16 .undefined
#d16 .undefined
#d16 .undefined
#d16 .undefined
#d16 .undefined
#d16 .undefined
#d16 .undefined
#d16 .undefined
#d16 .undefined
#d16 .undefined ; E0
#d16 .undefined
#d16 .undefined
#d16 .undefined
#d16 .undefined
#d16 .undefined
#d16 .undefined
#d16 .undefined
#d16 .undefined
#d16 .undefined
#d16 .undefined
#d16 .undefined
#d16 .undefined
#d16 .undefined
#d16 .undefined
#d16 .undefined
#d16 .undefined ; F0
#d16 .undefined
#d16 .undefined
#d16 .undefined
#d16 .undefined
#d16 .undefined
#d16 .undefined
#d16 .undefined
#d16 .undefined
#d16 .undefined
#d16 .undefined
#d16 .undefined
#d16 .undefined
#d16 .undefined
#d16 .undefined
#d16 .undefined

.undefined:
#d "\n\0"

.mov_a_i8:
#d "mov a, @\n\0"
.mov_b_i8:
#d "mov b, @\n\0"
.mov_c_i8:
#d "mov c, @\n\0"
.mov_d_i8:
#d "mov d, @\n\0"
.mov_e_i8:
#d "mov e, @\n\0"

.mov_bc_i16:
#d "mov bc, @@\n\0"
.mov_de_i16:
#d "mov de, @@\n\0"
.mov_sp_i16:
#d "mov sp, @@\n\0"

.add_i8:
#d "add @\n\0"
.sub_i8:
#d "sub @\n\0"
.and_i8:
#d "and @\n\0"
.nand_i8:
#d "nand @\n\0"
.or_i8:
#d "or @\n\0"
.nor_i8:
#d "nor @\n\0"
.xor_i8:
#d "xor @\n\0"

.add_b:
#d "add b\n\0"
.sub_b:
#d "sub b\n\0"
.and_b:
#d "and b\n\0"
.nand_b:
#d "nand b\n\0"
.or_b:
#d "or b\n\0"
.nor_b:
#d "nor b\n\0"
.xor_b:
#d "xor b\n\0"

.add_c:
#d "add c\n\0"
.sub_c:
#d "sub c\n\0"
.and_c:
#d "and c\n\0"
.nand_c:
#d "nand c\n\0"
.or_c:
#d "or c\n\0"
.nor_c:
#d "nor c\n\0"
.xor_c:
#d "xor c\n\0"

.add_d:
#d "add d\n\0"
.sub_d:
#d "sub d\n\0"
.and_d:
#d "and d\n\0"
.nand_d:
#d "nand d\n\0"
.or_d:
#d "or d\n\0"
.nor_d:
#d "nor d\n\0"
.xor_d:
#d "xor d\n\0"

.add_e:
#d "add e\n\0"
.sub_e:
#d "sub e\n\0"
.and_e:
#d "and e\n\0"
.nand_e:
#d "nand e\n\0"
.or_e:
#d "or e\n\0"
.nor_e:
#d "nor e\n\0"
.xor_e:
#d "xor e\n\0"

.add_at_bc:
#d "add [bc]\n\0"
.sub_at_bc:
#d "sub [bc]\n\0"
.and_at_bc:
#d "and [bc]\n\0"
.nand_at_bc:
#d "nand [bc]\n\0"
.or_at_bc:
#d "or [bc]\n\0"
.nor_at_bc:
#d "nor [bc]\n\0"
.xor_at_bc:
#d "xor [bc]\n\0"

.add_at_de:
#d "add [de]\n\0"
.sub_at_de:
#d "sub [de]\n\0"
.and_at_de:
#d "and [de]\n\0"
.nand_at_de:
#d "nand [de]\n\0"
.or_at_de:
#d "or [de]\n\0"
.nor_at_de:
#d "nor [de]\n\0"
.xor_at_de:
#d "xor [de]\n\0"

.not:
#d "not\n\0"

.push_a:
#d "push a\n\0"
.push_b:
#d "push b\n\0"
.push_c:
#d "push c\n\0"
.push_d:
#d "push d\n\0"
.push_e:
#d "push e\n\0"

.pop_a:
#d "pop a\n\0"
.pop_b:
#d "pop b\n\0"
.pop_c:
#d "pop c\n\0"
.pop_d:
#d "pop d\n\0"
.pop_e:
#d "pop e\n\0"

.push_bc:
#d "push bc\n\0"
.push_de:
#d "push de\n\0"

.pop_bc:
#d "pop bc\n\0"
.pop_de:
#d "pop de\n\0"

.inc_bc:
#d "inc bc\n\0"
.inc_de:
#d "inc de\n\0"

.dec_bc:
#d "dec bc\n\0"
.dec_de:
#d "dec de\n\0"

.jmp_i16:
#d "jmp @@\n\0"
.jmp_bc:
#d "jmp bc\n\0"
.jmp_de:
#d "jmp de\n\0"
.jmp_at_bc:
#d "jmp [bc]\n\0"
.jmp_at_de:
#d "jmp [de]\n\0"

.jc_i16:
#d "jc @@\n\0"
.jc_bc:
#d "jc bc\n\0"
.jc_de:
#d "jc de\n\0"
.jc_at_bc:
#d "jc [bc]\n\0"
.jc_at_de:
#d "jc [de]\n\0"

.jnc_i16:
#d "jnc @@\n\0"
.jnc_bc:
#d "jnc bc\n\0"
.jnc_de:
#d "jnc de\n\0"
.jnc_at_bc:
#d "jnc [bc]\n\0"
.jnc_at_de:
#d "jnc [de]\n\0"

.je_i16:
#d "je @@\n\0"
.je_bc:
#d "je bc\n\0"
.je_de:
#d "je de\n\0"
.je_at_bc:
#d "je [bc]\n\0"
.je_at_de:
#d "je [de]\n\0"

.jne_i16:
#d "jne @@\n\0"
.jne_bc:
#d "jne bc\n\0"
.jne_de:
#d "jne de\n\0"
.jne_at_bc:
#d "jne [bc]\n\0"
.jne_at_de:
#d "jne [de]\n\0"

.cmp_i8:
#d "cmp @\n\0"
.cmp_b:
#d "cmp b\n\0"
.cmp_c:
#d "cmp c\n\0"
.cmp_d:
#d "cmp d\n\0"
.cmp_e:
#d "cmp e\n\0"
.cmp_at_bc:
#d "cmp [bc]\n\0"
.cmp_at_de:
#d "cmp [de]\n\0"

.mov_a_at_bc:
#d "mov a, [bc]\n\0"
.mov_d_at_bc:
#d "mov d, [bc]\n\0"
.mov_e_at_bc:
#d "mov e, [bc]\n\0"

.mov_a_at_de:
#d "mov a, [de]\n\0"
.mov_b_at_de:
#d "mov b, [de]\n\0"
.mov_c_at_de:
#d "mov c, [de]\n\0"

.mov_at_bc_a:
#d "mov [bc], a\n\0"
.mov_at_bc_d:
#d "mov [bc], d\n\0"
.mov_at_bc_e:
#d "mov [bc], e\n\0"

.mov_at_de_a:
#d "mov [de], a\n\0"
.mov_at_de_b:
#d "mov [de], b\n\0"
.mov_at_de_c:
#d "mov [de], c\n\0"

.mov_bc_at_de:
#d "mov bc, [de]\n\0"
.mov_de_at_bc:
#d "mov de, [bc]\n\0"

.mov_at_bc_de:
#d "mov [bc], de\n\0"
.mov_at_de_bc:
#d "mov [de], bc\n\0"

.call_i16:
#d "call @@\n\0"
.call_bc:
#d "call bc\n\0"
.call_de:
#d "call de\n\0"
.call_at_bc:
#d "call [bc]\n\0"
.call_at_de:
#d "call [de]\n\0"

.ret:
#d "ret\n\0"

.mov_b_a:
#d "mov b, a\n\0"
.mov_b_c:
#d "mov b, c\n\0"
.mov_b_d:
#d "mov b, d\n\0"
.mov_b_e:
#d "mov b, e\n\0"

.mov_c_a:
#d "mov c, a\n\0"
.mov_c_b:
#d "mov c, b\n\0"
.mov_c_d:
#d "mov c, d\n\0"
.mov_c_e:
#d "mov c, e\n\0"

.mov_d_a:
#d "mov d, a\n\0"
.mov_d_b:
#d "mov d, b\n\0"
.mov_d_c:
#d "mov d, c\n\0"
.mov_d_e:
#d "mov d, e\n\0"

.mov_e_a:
#d "mov e, a\n\0"
.mov_e_b:
#d "mov e, b\n\0"
.mov_e_c:
#d "mov e, c\n\0"
.mov_e_d:
#d "mov e, d\n\0"

.mov_bc_de:
#d "mov bc, de\n\0"
.mov_bc_sp:
#d "mov bc, sp\n\0"

.mov_de_bc:
#d "mov de, bc\n\0"
.mov_de_sp:
#d "mov de, sp\n\0"

.mov_sp_bc:
#d "mov sp, bc\n\0"
.mov_sp_de:
#d "mov sp, de\n\0"

.rol:
#d "rol\n\0"

.mov_bc_sp_plus_i8:
#d "mov bc, sp+@\n\0"
.mov_de_sp_plus_i8:
#d "mov de, sp+@\n\0"

.inc_b:
#d "inc b\n\0"
.inc_c:
#d "inc c\n\0"
.inc_d:
#d "inc d\n\0"
.inc_e:
#d "inc e\n\0"

.dec_b:
#d "dec b\n\0"
.dec_c:
#d "dec c\n\0"
.dec_d:
#d "dec d\n\0"
.dec_e:
#d "dec e\n\0"

.mov_a_b:
#d "mov a, b\n\0"
.mov_a_c:
#d "mov a, c\n\0"
.mov_a_d:
#d "mov a, d\n\0"
.mov_a_e:
#d "mov a, e\n\0"

.mov_bc_sp_minus_i8:
#d "mov bc, sp-@\n\0"
.mov_de_sp_minus_i8:
#d "mov de, sp-@\n\0"

.mov_sp_sp_plus_i8:
#d "mov sp, sp+@\n\0"
.mov_sp_sp_minus_i8:
#d "mov sp, sp-@\n\0"

.tei:
#d "tei\n\0"
.reti:
#d "reti\n\0"

.ldc:
#d "ldc\n\0"
.lde:
#d "lde\n\0"

.pushf:
#d "pushf\n\0"
.popf:
#d "popf\n\0"
