edwardatki/e74-cpu/(commit log)

2023-08-22 Register board schematic
    [Register_board.kicad_pcb, Register_board.kicad_sch, cpu.circ]
2023-08-23 Register board
    [Register_board.kicad_pcb, Register_board.kicad_sch, cpu.circ]
2023-08-23 Control panel schematic
    [Control_panel.kicad_pcb, Control_panel.kicad_sch, Register_board.kicad_pcb, Register_board.kicad_sch]
2023-08-25 Register board and Control panel ordered
    [Control_panel-CuBottom.gbr, Control_panel-CuTop.gbr, Control_panel-EdgeCuts.gbr, Control_panel-MaskBottom.gbr, Control_panel-MaskTop.gbr, Control_panel-NPTH.drl, Control_panel-PTH.drl, Control_panel-PasteBottom.gbr]
2023-08-31 More instructions implemented
    [cpu.circ]
2023-09-02 Started on microcode control board
    [Control_board.kicad_pcb, Control_board.kicad_sch]
2023-09-02 Fix address line labelling error
    [Register_board.kicad_pcb, Register_board.kicad_sch]
2023-09-03 Control board progress
    [Control_board.kicad_sch]
2023-09-04 No progress but more thoughts
    [Control_board.kicad_sch]
2023-09-05 Clock generator done... probably
    [Control_board.kicad_sch]
2023-09-08 Control board schematic done?
    [Control_board.kicad_pcb, Control_board.kicad_sch, Register_board.kicad_sch]
2023-09-09 Control board ready for routing
    [Control_board.kicad_pcb, Control_board.kicad_sch]
2023-09-10 Control board and connector bridge ready for ordering
    [Bridge-CuBottom.gbr, Bridge-CuTop.gbr, Bridge-EdgeCuts.gbr, Bridge-MaskBottom.gbr, Bridge-MaskTop.gbr, Bridge-NPTH.drl, Bridge-PTH.drl, Bridge-PasteBottom.gbr]
2023-09-10 Memory board
    [Control_board-CuBottom.gbr, Control_board-CuTop.gbr, Control_board-EdgeCuts.gbr, Control_board-MaskBottom.gbr, Control_board-MaskTop.gbr, Control_board-PTH.drl, Control_board-PasteTop.gbr, Control_board-SilkBottom.gbr]
2023-09-11 Update logisim to match actual boards
    [cpu.circ]
2023-09-12 Fix broken logisim 74181
    [74.circ, 74181.circ, cpu.circ]
2023-09-13 Simple monitor working
    [cpu.circ]
2023-09-13 Some demo programs
    [cpu.circ]
2023-09-14 Fast primes demo
    [cpu.circ]
2023-09-19 Lowercase, whitespace skipping, optional end address argument for disassemble
    [main.asm]
2023-09-20 Actual hardware printed its first characters!
2023-10-02 Variable clock speed, real hardware becomes unstable above ~ 2KHz
    [clock_generator.ino]
2024-01-05 Move hardware to new folder and delete outdated designs
    [Bridge-CuBottom.gbr, Bridge-CuTop.gbr, Bridge-EdgeCuts.gbr, Bridge-MaskBottom.gbr, Bridge-MaskTop.gbr, Bridge-NPTH.drl, Bridge-PTH.drl, Bridge-PasteBottom.gbr]
2024-01-12 Fix and update logisim simulation
    [cpu.circ]
